gcharvin/esp32_temperature_controller/pc_control/readme.txt

 command used to generate .exe:

python -m PyInstaller --onefile --noconsole --name temperature_controller main.py
