gcharvin/esp32_temperature_controller/(list of files, cad)

Other CAD files:
generic_controller v21.f3z
