gcharvin/esp32_temperature_controller/esp32_temperature_controller.ino

#define DEBUG true

#include <Wire.h>
#include <Adafruit_GFX.h>
#include <Adafruit_SSD1306.h>
#include <DHT.h>
#include <math.h>
#include <PID_v2.h>
#include <Preferences.h>
#include <ESP32RotaryEncoder.h>
#include "menu.h"
#include "parameters.h"  // Inclusion de parameters.h

// https://www.upesy.fr/blogs/tutorials/esp32-pinout-reference-gpio-pins-ultimate-guide

// Stockage en mémoire
Preferences preferences;

// OLED display size
#define SCREEN_WIDTH 128
#define SCREEN_HEIGHT 64
#define OLED_RESET -1
#define OLED_ADDRESS 0x3C // Adresse I2C de l'OLED
Adafruit_SSD1306 display(SCREEN_WIDTH, SCREEN_HEIGHT, &Wire, OLED_RESET);

// DHT22 sensor settings
#define DHTPIN 18
#define DHTTYPE DHT22
DHT dht(DHTPIN, DHTTYPE);

// PWM settings
const int mosfetPin = 5;
const int pwmChannel = 0;
const int pwmFrequency = 500; // 100 % with 5000Hz I had interference and poor thermistor reading !
const int pwmResolution = 8;

// Thermistor settings
int thermistorPin = 15;
float divisorValue = 8400.0; // recalibrated using DHT22
float Bvalue = 3920.0; // extracted from datsheet values : https://www.ovenind.com/pdf/datasheets/DS-TR136.pdf

// Déclaration des paramètres
float Setpoint;
float Kp, Ki, Kd;
float resistorValue;
double Input, Output;
float dhtTemperatureC;

// Tableau unique contenant tous les paramètres
Parameter parameters[] = {
    {"Setpoint", &Setpoint, 32.0, 20.0, 40.0, 0.1},
    {"Kp", &Kp, 40.0, 0.0, 100.0, 0.1},
    {"Ki", &Ki, 8.0, 0.0, 50.0, 0.1},
    {"Kd", &Kd, 0.0, 0.0, 10.0, 0.1},
    {"resistorValue", &resistorValue, 15000.0, 1000.0, 30000.0, 500.0}
};

// Nombre total de paramètres
const int numParameters = sizeof(parameters) / sizeof(Parameter);

// PID controller
PID_v2 myPID( Kp, Ki, Kd, PID::Direct);

// Déclaration des broches pour l'encodeur
#define encoder0PinA  4  // Pin A de l'encodeur
#define encoder0PinB  19 // Pin B de l'encodeur
#define encoder0Press 23  // Pin du bouton de l'encodeur

RotaryEncoder rotaryEncoder(encoder0PinA, encoder0PinB, encoder0Press);

unsigned long lastPIDTime = 0;
unsigned long lastDisplayTime = 0;
const long PIDInterval = 500;
const long DisplayInterval = 500;
bool displayNeedsUpdate=true;

// Function declarations
void setupPWM();
void setupOLED();
void setupPID();
bool readThermistor();
void updatePID();
void debugPrint();
void handleSerialCommand();

bool initSuccess = true;
String serialBuffer = ""; // Tampon pour stocker les caractères reçus


void setup() {
  Serial.begin(9600);
  debugPrint("Init components setup");

  // Setup OLED
  setupOLED();

  debugPrint("Get parameters");
  preferences.begin("my-app", false);
  for (int i = 0; i < numParameters; i++) {
    *(parameters[i].value) = preferences.getFloat(parameters[i].name, parameters[i].defaultValue);
  }

  debugPrint("Init PID");
  myPID.SetTunings(Kp, Ki, Kd);
  myPID.SetOutputLimits(0, 255);
  bool error=readThermistor();

  if (error) {
    debugPrint("Thermistor sensor failed!");
  } else {
    debugPrint("Thermistor OK");
  }


  myPID.Start(Input, 0, Setpoint);

  debugPrint("Setup Encoder");

    pinMode(encoder0Press, INPUT_PULLUP);  // Assurez-vous que la résistance pull-up interne est activée pour le bouton
    rotaryEncoder.setEncoderType(EncoderType::HAS_PULLUP);
    rotaryEncoder.setBoundaries(0, numParameters, true); // Limite le range de 0 à numParameters
    rotaryEncoder.onTurned(&knobCallback);
    rotaryEncoder.onPressed(&buttonCallback);
    rotaryEncoder.begin();

  // rotaryEncoder.setEncoderType(EncoderType::HAS_PULLUP);
  // rotaryEncoder.setBoundaries(0, 5, true);
  // rotaryEncoder.onTurned(&knobCallback);
  // rotaryEncoder.onPressed(&buttonCallback);
  // rotaryEncoder.begin();
  debugPrint("Encoder OK");

  setupPWM();

  debugPrint("DHT22 sensor setup");
  dht.begin();
  float temperature = dht.readTemperature();
  if (isnan(temperature)) {
    debugPrint("DHT sensor failed!");
  } else {
    debugPrint("DHT sensor OK");
  }

  debugPrint("Init procedure OK");
  delay(1000);


   updateDisplay(error);
}

void loop() {
    if (!initSuccess) return;
    unsigned long currentTime = millis();

    // Gérer les commandes reçues sur le port série
    if (Serial.available() > 0) {
        handleSerialCommand();
    }

    // Lire la thermistance et mettre à jour le PID, sauf si en mode d'édition
    bool error = false;
    if (!menuActive || (menuActive && !editing)) {
        if (currentTime - lastPIDTime >= PIDInterval) {
            lastPIDTime = currentTime;
            error = readThermistor();
            if (!error) {
                updatePID();
            } else {
                // Forcer le PWM à 0% en cas d'erreur
                Output = 0;
                ledcWrite(mosfetPin, Output);
            }
            dhtTemperatureC = dht.readTemperature();
        }
    }

    // Gérer l'affichage et le menu
    if (menuActive) {
        if (editing) {
            if (displayNeedsUpdate) {
                showSingleParameter(editIndex);
                displayNeedsUpdate = false;
            }
        } else {
            if (displayNeedsUpdate) {
                showMenu();
                displayNeedsUpdate = false;
            }
        }
    } else {
        if (currentTime - lastDisplayTime >= DisplayInterval) {
            lastDisplayTime = currentTime;
            updateDisplay(error); // Passer l'erreur à updateDisplay()
        }
    }
}



void debugPrint(const char* message) {
  if (DEBUG) {
    Serial.println(message);
  }

  if(oledInitialized) {
      displayTextLine(message);
      delay(500);
  }
}


void setupPWM() {
  if (DEBUG) {
    Serial.println("Init PWM");
  }
  ledcAttach(mosfetPin, pwmFrequency, pwmResolution);
}

void setupOLED() {
 
debugPrint("Init OLED");

 bool error= display.begin(SSD1306_SWITCHCAPVCC, OLED_ADDRESS); 
 
  if (error) {
        // Essayer d'écrire puis lire quelque chose sur l'écran pour vérifier
        display.clearDisplay();
        display.drawPixel(0, 0, SSD1306_WHITE); // Dessiner un pixel en haut à gauche
        display.display();
        delay(10); // Attendre un instant pour donner le temps d'afficher

        // Essayer de vérifier si l'écran répond correctement en lisant un état
        if (Wire.requestFrom(OLED_ADDRESS, 1) == 1) {
            oledInitialized = true;
            debugPrint("OLED setup successful");
           
        } else {
            oledInitialized = false;
            debugPrint("OLED not detected!");
        }
    } else {
        oledInitialized = false;
        debugPrint("OLED initi failed!");
    }

}

void setupPID() {
  pinMode(mosfetPin, OUTPUT);
  
  if (DEBUG) {
    Serial.println("Init PID");
  }
  myPID.SetOutputLimits(0, 255);
  myPID.Start(25, 0, Setpoint);
}

bool readThermistor() {
    int adcValue = analogRead(thermistorPin);
    float voltage = adcValue * (3.3 / 4095.0);

    if (voltage != 0) {
        float thermistorResistance = divisorValue * (3.3 / voltage - 1.0);

        if (thermistorResistance > 0) {
            float temp = 1.0 / (log(thermistorResistance / resistorValue) / Bvalue + 1.0 / 298.15) - 273.15;

            if (temp > 0) {
                Input = temp;

                // Vérifiez si la température dépasse 45°C
                if (temp > 45.0) {
                    if (DEBUG) {
                        Serial.println("Erreur : Température > 45°C !");
                    }
                    return true; // Erreur : température trop élevée
                }
            }
        }
        return false; // Pas d'erreur
    } else {
        if (DEBUG) {
            Serial.println("Thermistor: Tension est 0, erreur détectée !");
        }
        return true; // Erreur : tension de la thermistance est 0
    }
}

void updatePID() {
    // Mise à jour de la sortie PID
    Output = myPID.Run(Input);
    ledcWrite(mosfetPin, Output);

    // Affichage des informations PID et des paramètres stockés sur une seule ligne
    if (DEBUG) {
        Serial.print("Setpoint: ");
        Serial.print(Setpoint);
        Serial.print(", Input: ");
        Serial.print(Input);
        Serial.print(", Output: ");
        Serial.print(Output);

        // Afficher les paramètres stockés
        for (int i = 0; i < numParameters; i++) {
            float storedValue = preferences.getFloat(parameters[i].name, parameters[i].defaultValue);
            Serial.print(", ");
            Serial.print(parameters[i].name);
            Serial.print(": ");
            Serial.print(storedValue);
        }

        // Terminer la ligne
        Serial.println();
    }
}

void handleSerialCommand() {
    while (Serial.available() > 0) {
        char receivedChar = Serial.read(); // Lire un caractère
        if (receivedChar == '\n') {
            // Une commande complète a été reçue
            serialBuffer.trim(); // Supprimer les espaces inutiles

            if (serialBuffer.length() > 0) {
                // Traiter la commande reçue
                processCommand(serialBuffer);
            }

            // Réinitialiser le buffer pour la prochaine commande
            serialBuffer = "";
        } else {
            // Ajouter le caractère au buffer
            serialBuffer += receivedChar;
        }
    }
}

void processCommand(String command) {
    // Rechercher le délimiteur ":"
    int delimiterIndex = command.indexOf(':');
    if (delimiterIndex == -1) {
        Serial.println("Commande invalide. Format attendu : paramname : value");
        return;
    }

    // Extraire le nom du paramètre et la nouvelle valeur
    String paramName = command.substring(0, delimiterIndex);
    String paramValueStr = command.substring(delimiterIndex + 1);
    paramName.trim();
    paramValueStr.trim();

    // Convertir la valeur en float
    float paramValue = paramValueStr.toFloat();

    // Rechercher le paramètre dans le tableau
    for (int i = 0; i < numParameters; i++) {
        if (paramName == parameters[i].name) {
            // Vérifier si la valeur est dans les limites définies
            if (paramValue >= parameters[i].minValue && paramValue <= parameters[i].maxValue) {
                // Mettre à jour la valeur du paramètre
                *(parameters[i].value) = paramValue;

                // Sauvegarder la nouvelle valeur dans les préférences
                preferences.putFloat(parameters[i].name, paramValue);

                // Si c'est un paramètre PID ou Setpoint, appliquer les changements immédiatement
                if (paramName == "Kp" || paramName == "Ki" || paramName == "Kd" || paramName == "Setpoint") {
                    applyUpdatedParameters();
                }

                // Confirmer la mise à jour
                Serial.print("Parametre ");
                Serial.print(paramName);
                Serial.print(" updated with value : ");
                Serial.println(paramValue);

                return;
            } else {
                Serial.print("Value is outside bounds: ");
                Serial.print(paramName);
                Serial.print(". Min : ");
                Serial.print(parameters[i].minValue);
                Serial.print(", Max : ");
                Serial.println(parameters[i].maxValue);
                return;
            }
        }
    }

    // Si le paramètre n'est pas trouvé
    Serial.print("Paramètre inconnu : ");
    Serial.println(paramName);
}
