gcharvin/esp32_temperature_controller/(commit log)

2024-10-27 Rename temperature_controller_withmenu.ino to esp32_temperature_controller.ino
    changed name
2024-10-28 sensor calibration
2024-11-16 improved theristor error management
    [esp32_temperature_controller.ino, menu.cpp, menu.h]
2024-11-28 iproved two way communication , fixed many bugs
    [esp32_temperature_controller.ino, main.py, menu.cpp]
2024-12-01 multiple bug fixes + export as standalone .exe
    [main.py]
2025-02-20 Added excel file with parts
    [PartList.xlsx]
2025-02-20 Create generic_controller v21.f3z
    [generic_controller v21.f3z]
